nimaid/ReaXtrobe/README.md

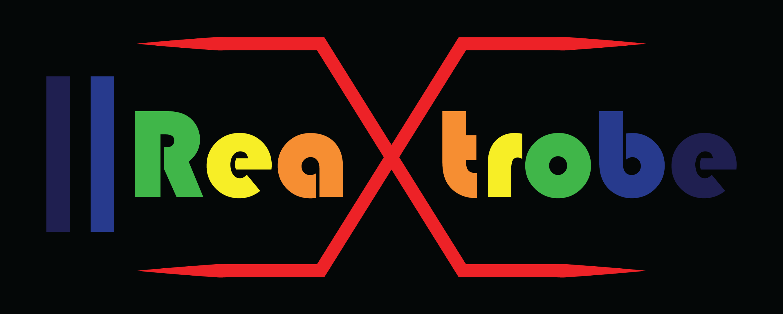
[picture p1: Logo/Color.png]
ReaXtrobe

An Open-Source Pitch-Reactive Addressable RGB LED Controller
