nimaid/ReaXtrobe/PCB/v1/ReaXtrobe BOM.xlsx

Qty | Reference Designators | Description | Manufacturer PN | Manufacturer | Supplier PN | Supplier | Notes | Sets | Qty In-House | Qty to Order
2 | C1, C2 | 22pF 6.3V 0603 SMD Ceramic Capacitor | CC0603JRNPO9BN220 | Yageo | 311-1062-1-ND | Digi-Key |  | 3x |  | 6 | https://www.digikey.com/short/p50t17
1 | C12 | 0.47uF 6.3V 0603 SMD Ceramic Capacitor | CL10B474KA8NFNC | Samsung Electro-Mechanics | 1276-2082-1-ND | Digi-Key |  |  |  | 3 | https://www.digikey.com/short/pdf0pw
3 | C3, C10, C11 | 0.1uF 6.3V 0603 SMD Ceramic Capacitor | CL10B104KB8NNNL | Samsung Electro-Mechanics | 1276-CL10B104KB8NNNLCT-ND | Digi-Key |  |  |  | 9
2 | C4, C5 | 1uF 6.3V 0603 SMD Ceramic Capacitor | CL10A105KP8NNNC | Samsung Electro-Mechanics | 1276-1182-1-ND | Digi-Key |  |  |  | 6
1 | C6 | 4.7uF 16V 1206 SMD Tantalum Capacitor | TAJA475K016RNJ | AVX Corporation | 478-3868-1-ND | Digi-Key |  |  |  | 3
1 | C7 | 10uF 20V 1206 SMD Tantalum Capacitor | F931D106MAA | AVX Corporation | 478-8275-1-ND | Digi-Key |  |  |  | 3
1 | C8 | 10uF 6.3V 1206 SMD Tantalum Capacitor | TAJA106K006RNJ | AVX Corporation | 478-1653-1-ND | Digi-Key |  |  |  | 3
1 | C9 | 2.2uF 6.3V 0603 SMD Ceramic Capacitor | CL10A225KQ8NNNC | Samsung Electro-Mechanics | 1276-1183-1-ND | Digi-Key |  |  |  | 3
1 | D1 | Red 0603 SMD LED | SML-D12U1WT86 | Rohm Semiconductor | SML-D12U1WT86CT-ND | Digi-Key |  |  |  | 3
1 | J1 | 0.1" 2x Screw Terminal | OSTVN02A150 | On Shore Technology Inc. | ED10561-ND | Digi-Key |  |  |  | 3
1 | J2 | 0.1" 3x Screw Terminal | OSTVN03A150 | On Shore Technology Inc. | ED10562-ND | Digi-Key |  |  |  | 3
1 | MIC1 | Electret THT Microphone | CMA-4544PF-W | CUI Inc. | 102-1721-ND | Digi-Key |  |  |  | 3
2 | R1, R2 | 1kΩ 0603 SMD Resistor | ESR03EZPJ102 | Rohm Semiconductor | RHM1.0KDCT-ND | Digi-Key |  |  |  | 6
1 | R3 | 2.2kΩ 0603 SMD Resistor | ERA-3AEB222V | Panasonic Electronic Components | P2.2KDBCT-ND | Digi-Key |  |  |  | 3
1 | R4 | 150kΩ 0603 SMD Resistor | CRGCQ0603F150K | TE Connectivity Passive Product | A129714CT-ND | Digi-Key |  |  |  | 3
1 | R5 | 100kΩ 0603 SMD Resistor | RR0816P-104-D | Susumu | RR08P100KDCT-ND | Digi-Key |  |  |  | 3
1 | U1 | Atmel 8-bit 32k SMD Microcontroller | ATMEGA328P-AU | Microchip Technology | ATMEGA328P-AURCT-ND | Digi-Key |  |  |  | 3
1 | U2 | 5V SMD Linear Voltage Regulator | NCP1117ST50T3G | ON Semiconductor | NCP1117ST50T3GOSCT-ND | Digi-Key |  |  |  | 3
1 | U3 | Electret Microphone Amplifier w/ AGC | MAX9814ETD+T | Maxim Integrated | MAX9814ETD+TCT-ND | Digi-Key |  |  |  | 3
1 | Y1 | 16MHz 18pF SMD Crystal | FA-238 16.0000MB-C3 | EPSON | SER3686CT-ND | Digi-Key |  |  |  | 3
0 |  |  |  |  |  |  |  |  |  | 0
0 |  |  |  |  |  |  |  |  |  | 0
0 |  |  |  |  |  |  |  |  |  | 0
0 |  |  |  |  |  |  |  |  |  | 0
0 |  |  |  |  |  |  |  |  |  | 0
0 |  |  |  |  |  |  |  |  |  | 0
0 |  |  |  |  |  |  |  |  |  | 0
0 |  |  |  |  |  |  |  |  |  | 0
0 |  |  |  |  |  |  |  |  |  | 0
0 |  |  |  |  |  |  |  |  |  | 0
0 |  |  |  |  |  |  |  |  |  | 0
0 |  |  |  |  |  |  |  |  |  | 0
0 |  |  |  |  |  |  |  |  |  | 0
0 |  |  |  |  |  |  |  |  |  | 0
