nimaid/ReaXtrobe/Case/Snap/v1/ReaXtrobe Case Snap v1 Top.stl

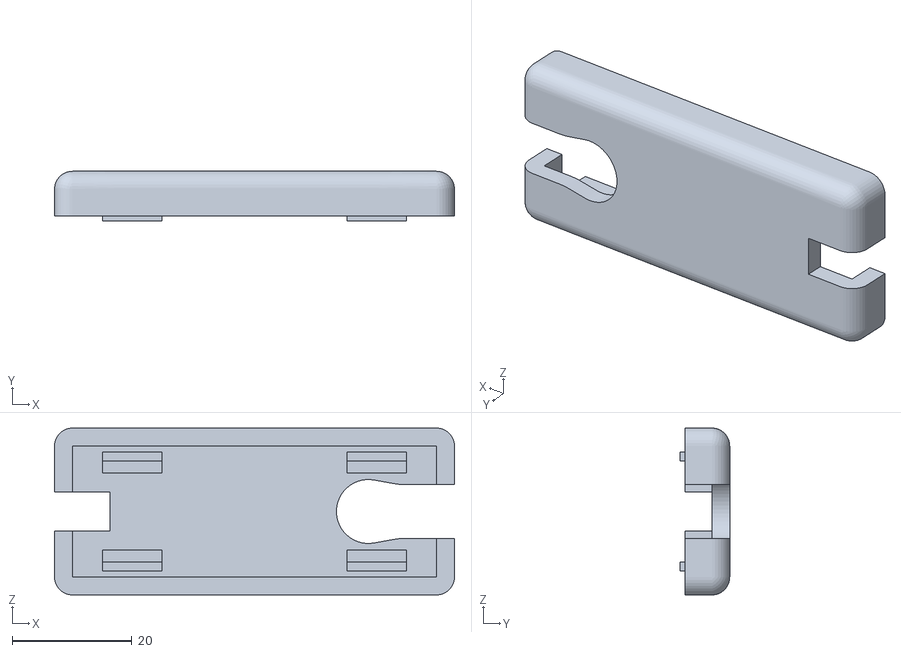
[picture p2: CAD file, 2019-08-21]
Case/Snap/v1/ReaXtrobe Case Snap v1 Top.stl
66.9 x 8.28 x 27.9
