nimaid/ReaXtrobe/Case/Snap/v1/ReaXtrobe Case Snap v1 Bottom.stl

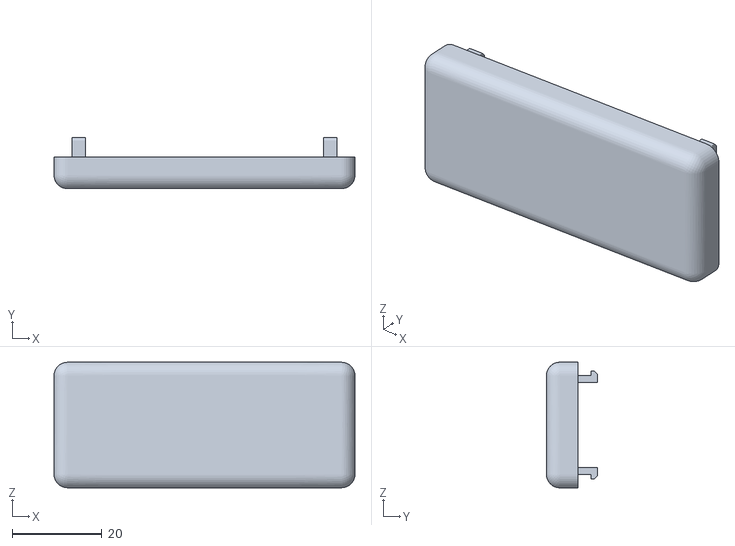
[picture p3: CAD file, 2019-08-21]
Case/Snap/v1/ReaXtrobe Case Snap v1 Bottom.stl
66.9 x 11.4 x 27.9
