nimaid/ReaXtrobe/(list of files, cad)

Other CAD files:
Logo/PCB.dxf
Case/Snap/v1/ReaXtrobe Case Snap v1.f3z
