nimaid/ReaXtrobe/PCB/v1/ReaXtrobe.pdf

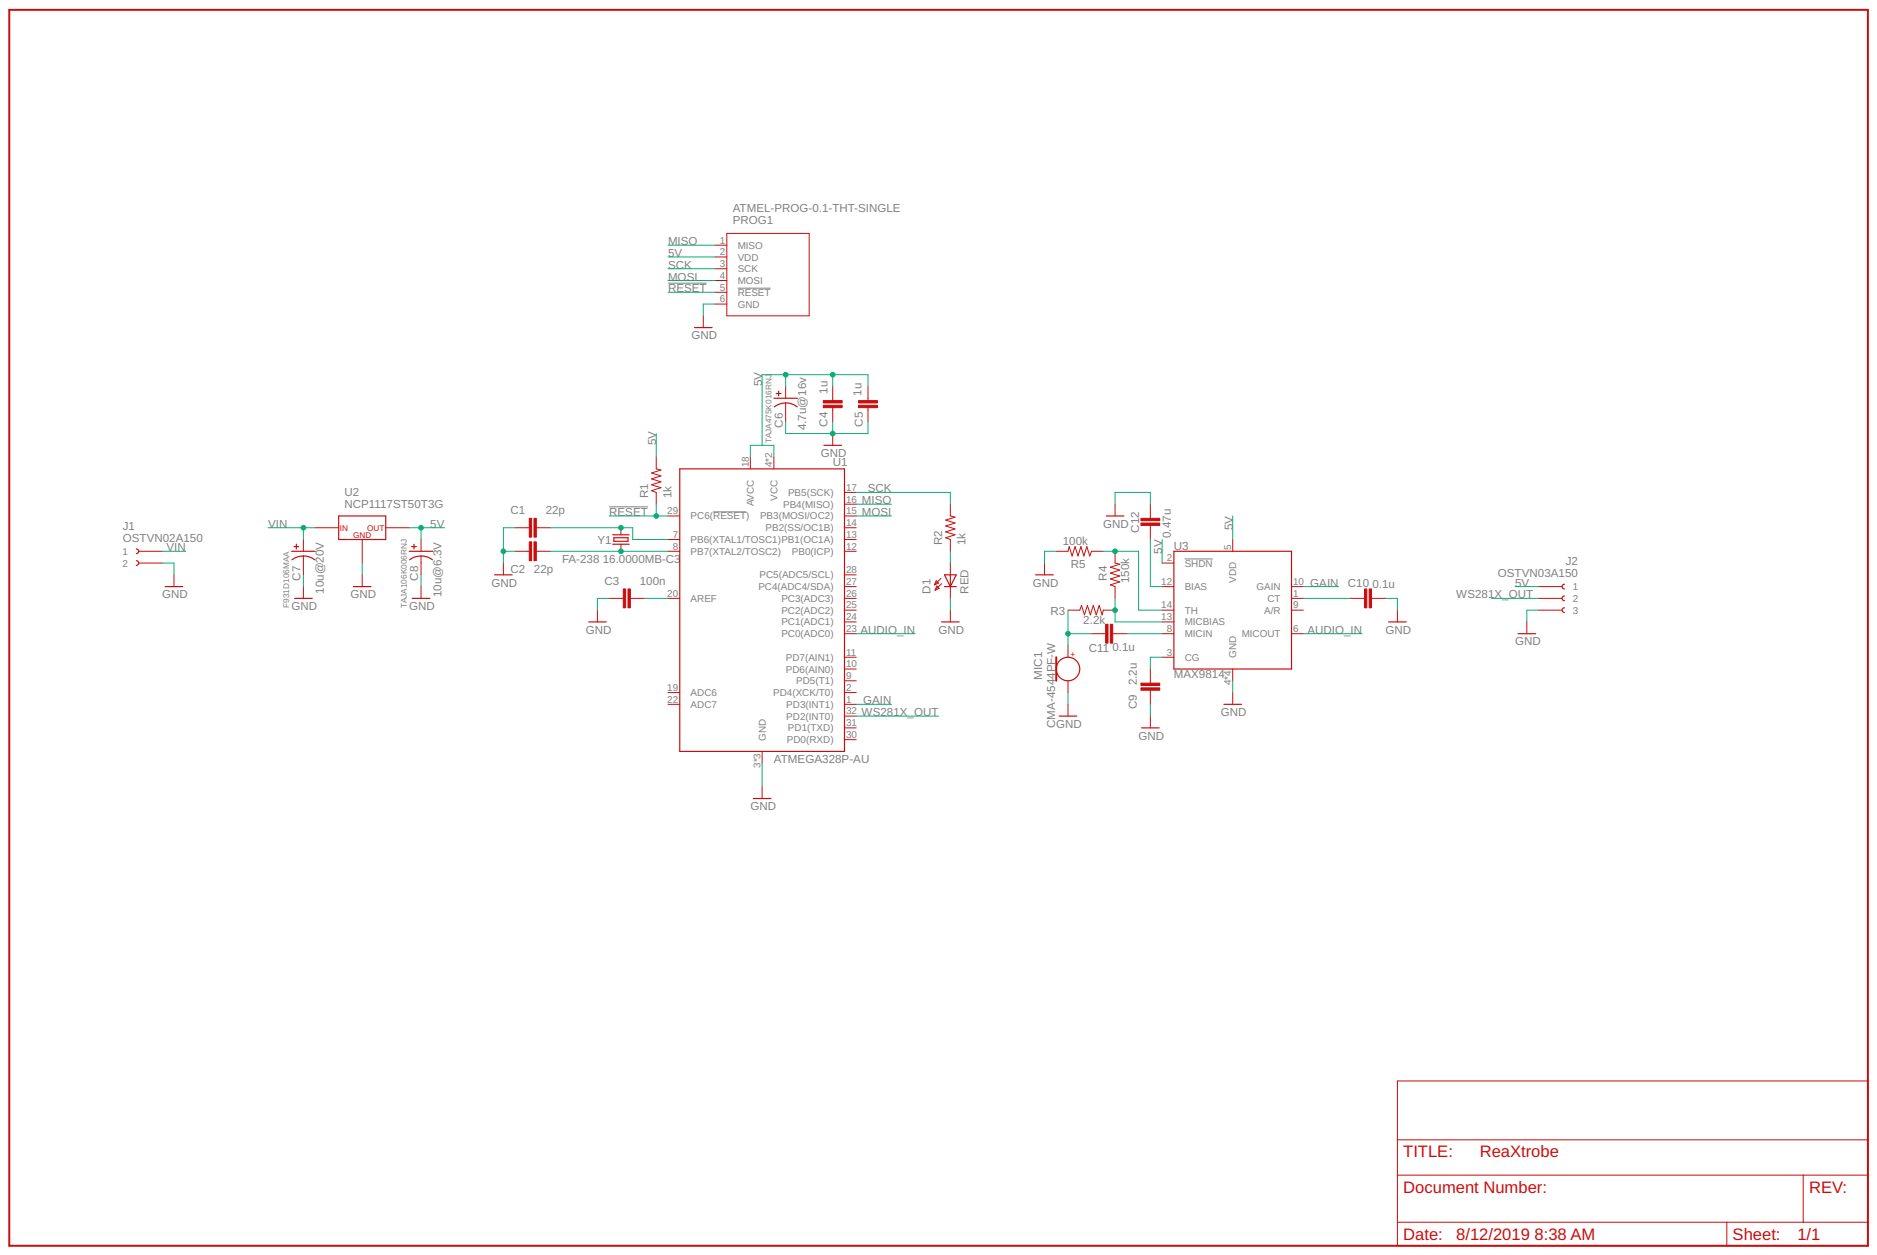
[picture p4: page 1]

ATMEL-PROG-0.1-THT-SINGLE
PROG1

Document Number: | REV:

Date: 8/12/2019 8:38 AM | Sheet: 1/1
