nimaid/ReaXtrobe/PCB/v1/ReaXtrobe.brd

## EAGLE design PCB/v1/ReaXtrobe.brd (2019-11-18)

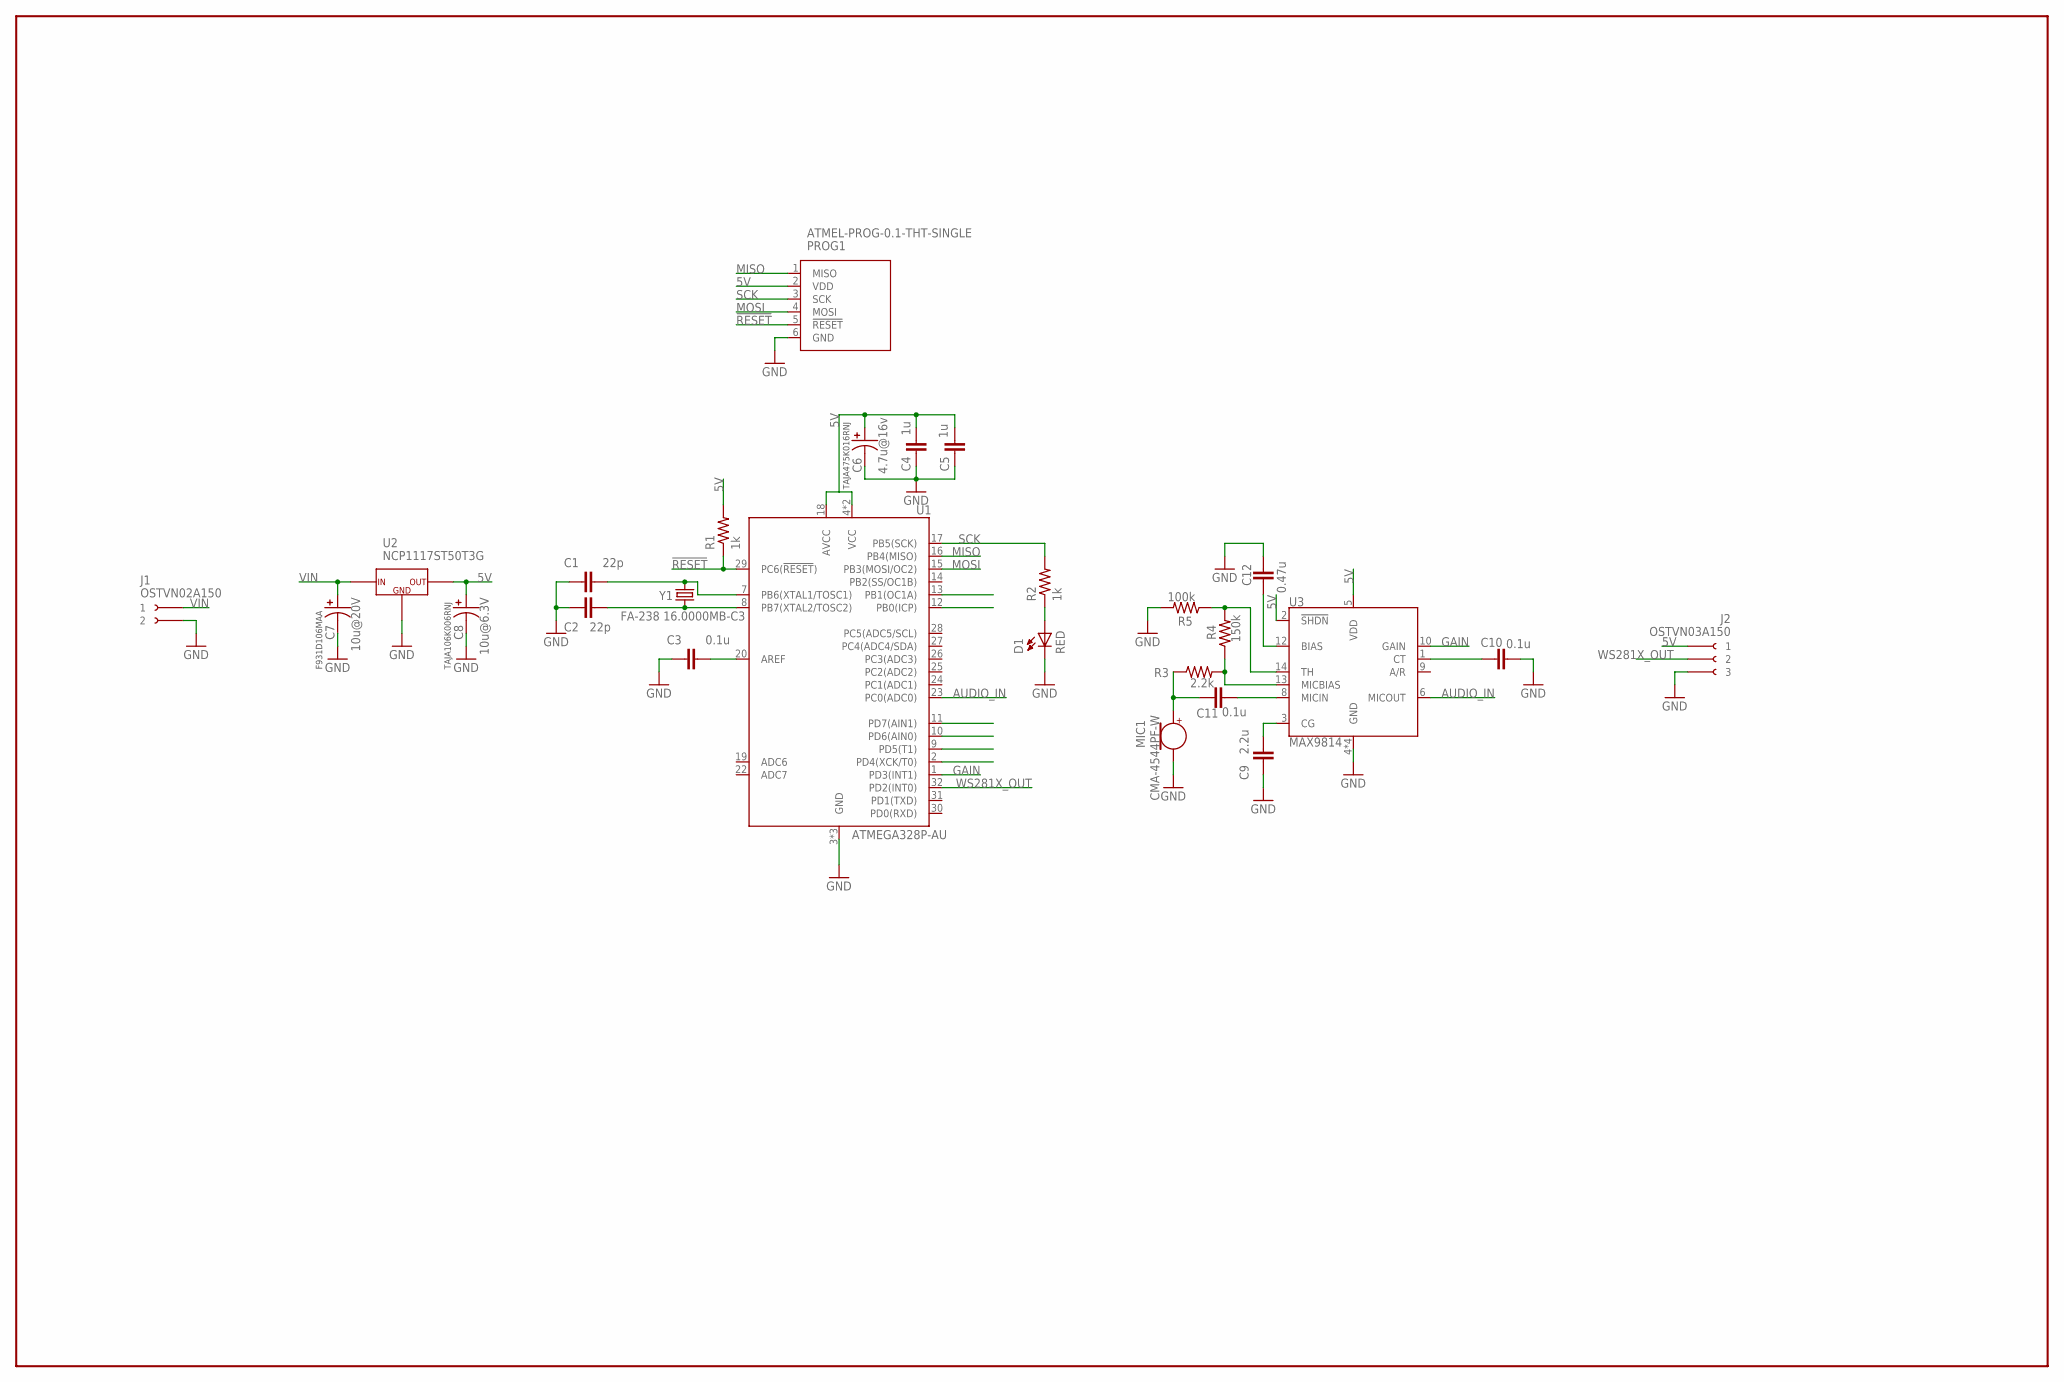
[picture p5: schematic ReaXtrobe.sch]

Parts:
C1, C2: 22p; C0603
C3, C10, C11: 0.1u; C0603
C4, C5: 1u; C0603
C6: 4.7u@16v; CAPMP3216X160
C7: 10u@20V; CAPMP3216X160
C8: 10u@6.3V; CAPMP3216X160
C9: 2.2u; C0603
C12: 0.47u; C0603
D1: RED; CHIP-LED0603
J1: OSTVN02A150
J2: OSTVN03A150
MIC1: CMA-4544PF-W; MIC_CMA-4544PF-W
PROG1: ATMEL-PROG-0.1-THT-SINGLE; HEADER-0.1-6
R1, R2: 1k; R0603
R3: 2.2k; R0603
R4: 150k; R0603
R5: 100k; R0603
U1: ATMEGA328P-AU; QFP80P900X900X120-32
U2: NCP1117ST50T3G; SOT223
U3: MAX9814; SON40P300X300X80-15T170X230
Y1: FA-238 16.0000MB-C3; OSCCC320X250X70

Connections:
5V: C4.2, C5.2, C6.A, C8.A, J2.P$1 (1), PROG1.2 (VDD), R1.2, U1.4 (VCC), U1.6 (VCC), U1.18 (AVCC), U2.2 (OUT), U3.2 (!SHDN), U3.5 (VDD)
!RESET: PROG1.5 (!RESET), R1.1, U1.29 (PC6(!RESET!))
AUDIO_IN: U1.23 (PC0(ADC0)), U3.6 (MICOUT)
GAIN: U1.1 (PD3(INT1)), U3.10 (GAIN)
GND: C1.1, C2.1, C3.1, C4.1, C5.1, C6.C, C7.C, C8.C, C9.1, C10.1, C12.1, D1.C (K), J1.P$2 (2), J2.P$3 (3), MIC1.2 (N), PROG1.6 (GND), R5.2, U1.3 (GND), U1.5 (GND), U1.21 (GND), U2.1 (GND), U3.4 (GND), U3.7 (GND), U3.11 (GND), U3.15 (GND)
MISO: PROG1.1 (MISO), U1.16 (PB4(MISO))
MOSI: PROG1.4 (MOSI), U1.15 (PB3(MOSI/OC2))
unnamed: C2.2, U1.8 (PB7(XTAL2/TOSC2)), Y1.1
unnamed: C1.2, U1.7 (PB6(XTAL1/TOSC1)), Y1.3 (2)
unnamed: C3.2, U1.20 (AREF)
unnamed: D1.A, R2.1
unnamed: C9.2, U3.3 (CG)
unnamed: C10.2, U3.1 (CT)
unnamed: C11.1, U3.8 (MICIN)
unnamed: C11.2, MIC1.1, R3.1
unnamed: R3.2, R4.1, U3.13 (MICBIAS)
unnamed: R4.2, R5.1, U3.14 (TH)
unnamed: C12.2, U3.12 (BIAS)
SCK: PROG1.3 (SCK), R2.2, U1.17 (PB5(SCK))
VIN: C7.A, J1.P$1 (1), U2.3 (IN)
WS281X_OUT: J2.P$2 (2), U1.32 (PD2(INT0))

Notes on the sheet:
TAJA475K016RNJ
F931D106MAA
TAJA106K006RNJ

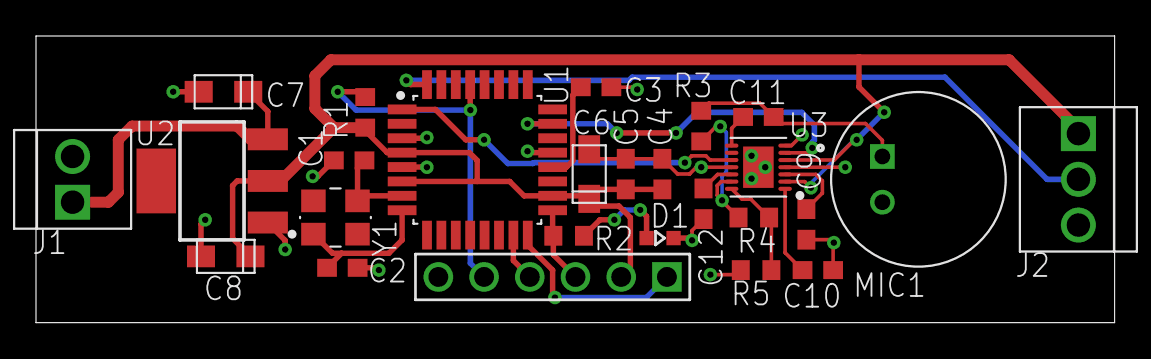
[picture p6: board ReaXtrobe.brd from above]

Board: 2 copper layers, 59.9 x 15.9 mm, 26 parts (0 on the bottom side), 21 nets.
