nimaid/ReaXtrobe/(commit log)

2019-08-11 Inital file sync
    [Reactrobe.brd, Reactrobe.sch]
2019-08-11 PDF schematic
2019-08-11 Add BOM
    [Reactrobe BOM.xlsx]
2019-08-12 PCB mods, added first untested case.
    [Reactrobe Case v21.f3z, Reactrobe.brd, Reactrobe.sch]
2019-08-18 Rename, Gerbers
    [ReaXtrobe BOM.xlsx, ReaXtrobe.brd, ReaXtrobe.sch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]
2019-08-18 Added new logo to board.
    [PCB.dxf, ReaXtrobe.brd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]
2019-08-21 V1 BOM
    [ReaXtrobe BOM.xlsx, ReaXtrobe.brd, ReaXtrobe.sch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]
2019-08-21 Snap case v1
    [ReaXtrobe Case Snap v1 Bottom.stl, ReaXtrobe Case Snap v1 Top.stl, ReaXtrobe Case Snap v1.f3z]
2019-11-18 Update BOM
    [ReaXtrobe BOM.xlsx, ReaXtrobe.brd]
